SamHakeem/Health-Monitoring-System-esp32/assets/gui_BTscan_screenshot.png

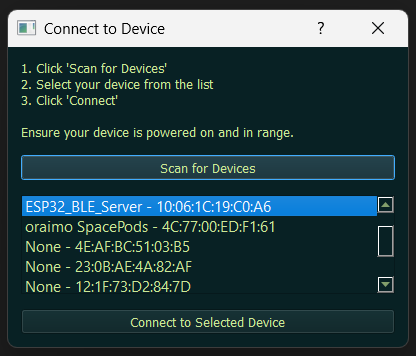
assets/gui_BTscan_screenshot.png
