SamHakeem/Health-Monitoring-System-esp32/assets/gui_connect_screenshot.png

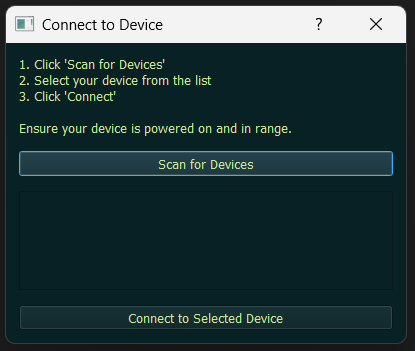
assets/gui_connect_screenshot.png
