SamHakeem/Health-Monitoring-System-esp32/assets/gui_customise_screenshot.png

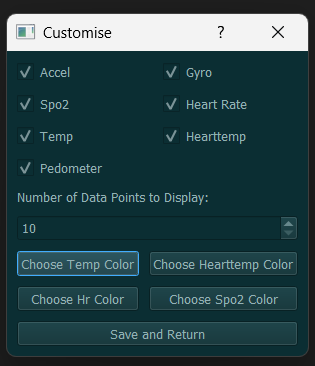
assets/gui_customise_screenshot.png
