SamHakeem/Health-Monitoring-System-esp32/assets/gui_main_program_screenshot.png

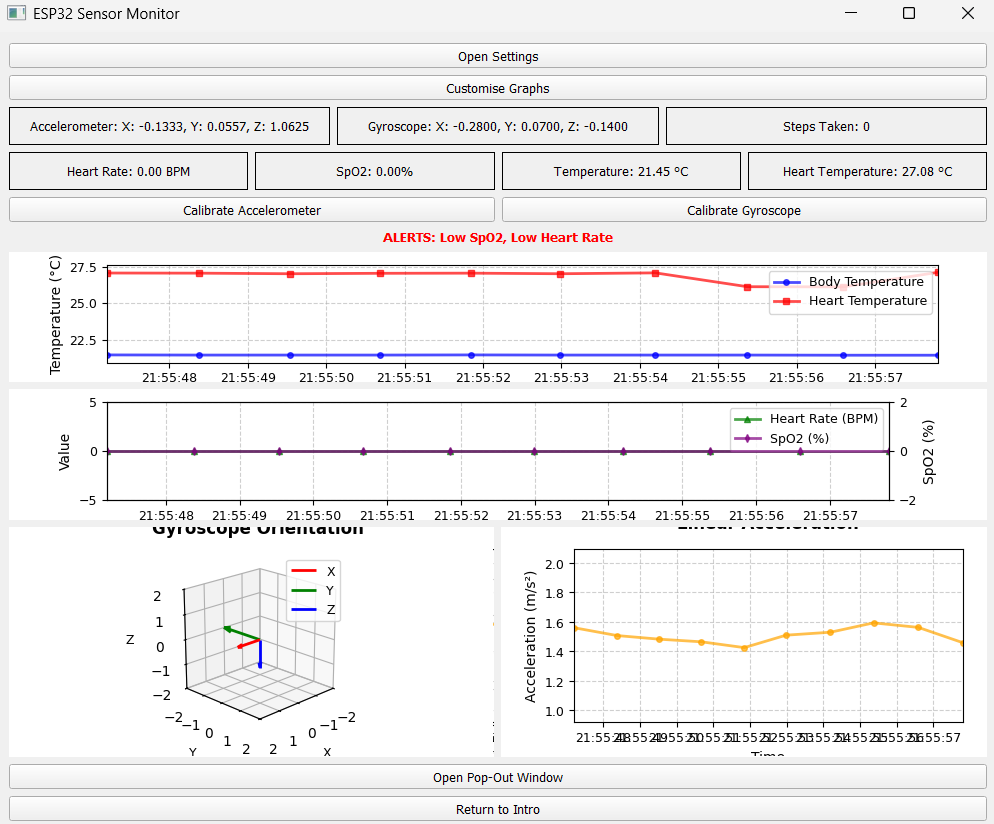
assets/gui_main_program_screenshot.png
