SamHakeem/Health-Monitoring-System-esp32/assets/gui_settings_screenshot.png

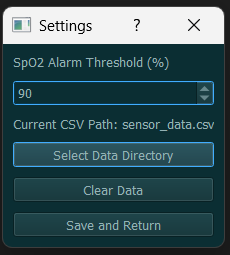
assets/gui_settings_screenshot.png
