SamHakeem/Health-Monitoring-System-esp32/assets/gui_start_screen_screenshot.png

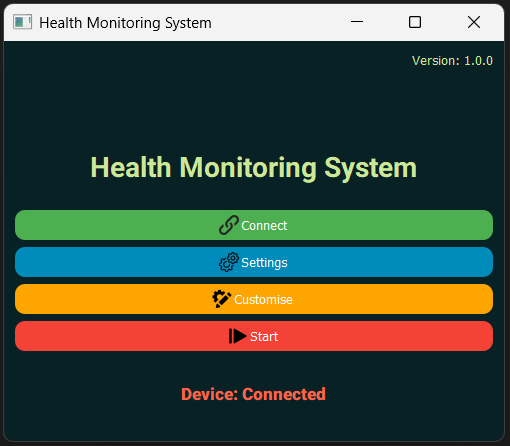
assets/gui_start_screen_screenshot.png
