SamHakeem/Health-Monitoring-System-esp32/(commit log)

2025-03-15 main framework
2025-03-15 SettingsWindow:
    Added a "Save and Return" button to save changes and close the window.
    CustomiseWindow:
    Added a "Save and Return" button to save changes and close the window.
    log_data Function:
    Added a global variable last_log_time to track the last log time.
    Ensured data is logged only once per second.
    [sensor_data.csv]
2025-03-15 MainProgram: Added a button (self.customise_button) to open the CustomiseWindow. Updated graph colors and visibility dynamically when changes are made in the CustomiseWindow.
    SettingsWindow:
    Removed age and weight inputs.
    Added a label to display the selected CSV file path.
    Ensured changes are saved and reflected in the MainProgram.
    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
    [sensor_data.csv]
2025-03-15 SettingsWindow: Swithced labels around
    [sensor_data.csv]
2025-03-15 refracted and organised code
    [sensor_data.csv]
2025-03-15 Summary of Changes: Dynamic Graph Limits: Added a graph_data_points attribute to SensorDataManager. Added a spin box in CustomiseWindow to allow users to adjust the number of data points. Updated upd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
    Resource Cleanup:
    Added a finally block in read_ble_data to ensure the BLE client is properly disconnected and resources are released.
    [sensor_data.csv]
2025-03-18 intro window adjustments
    [sensor_data.csv]
2025-03-26 added arduino file
2025-03-26 updated sensor value return
2025-03-28 removed attempted ThingSpeak integration
    attempted to transmit data from esp32 to ThingSpeak via WiFi. Available RAM on the ESP became an issue during building and compilation.
2025-05-21 added project report
    written project report concerning the development of this device, including original project aims and objectives, alongside evaluations and discussion of functionalities and aread of potential improvement.
2025-05-23 project structure update
    fixed project structure
    [sensor_data.csv]
